izzudin01/Design-of-Two-Stage-BJT-Common-Emitter-Amplifier-2N2222-/Final Project Report_Desain Two Stage BJT 2N2222 Common Emitter Amplifier.pdf

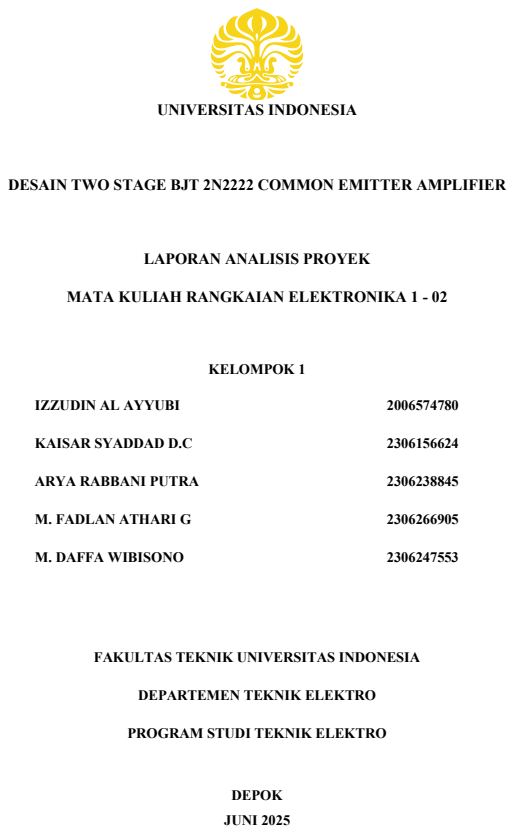
[picture p6: page 1]
UNIVERSITAS INDONESIA; KELOMPOK 1; IZZUDIN AL AYYUBI; KAISAR SYADDAD D.C; ARYA RABBANI PUTRA; M. FADLAN ATHARI G; M. DAFFA WIBISONO; DEPOK; JUNI 2025

DESAIN TWO STAGE BJT 2N2222 COMMON EMITTER AMPLIFIER

LAPORAN ANALISIS PROYEK

MATA KULIAH RANGKAIAN ELEKTRONIKA 1 - 02

FAKULTAS TEKNIK UNIVERSITAS INDONESIA

DEPARTEMEN TEKNIK ELEKTRO

PROGRAM STUDI TEKNIK ELEKTRO

i

DAFTAR ISI

### 4.1. Hasil Simulasi Rangkaian Two Stage BJT Common Emitter Amplifier . 18

4.1.1. Hasil Simulasi Interaktif Two Stage BJT Common Emitter Amplifier 18
4.1.2. Hasil Simulasi DC Operating Point Two Stage BJT Common Emitter
4.1.3. Hasil Simulasi AC Sweep Two Stage BJT Common Emitter Amplifier 22

### 4.2. Hasil Pengujian Rangkaian Two Stage BJT Common Emitter Amplifier

24

ii

DAFTAR GAMBAR

Gambar 3-1 Rangkaian Two Stage BJT Common Emitter Amplifier dengan Emitter

Gambar 3-3 Diagram Rangkaian Two Stage BJT 2N2222 Common Emitter Amplifier14

Gambar 4-1 Grafik Simulasi Rangkaian Two Stage BJT CE Amplifier dengan

iii

DAFTAR TABEL

Tabel 4-2 Perbandingan Nilai Perhitungan Teoritis dan Hasil Simulasi DC Operating

BAB 1

PENDAHULUAN

### 1.1. Latar Belakang

Penguat sinyal merupakan salah satu komponen penting dalam sistem elektronika,

terutama pada perangkat audio, komunikasi, dan instrumentasi. Salah satu konfigurasi

yang sering digunakan dalam penguatan sinyal analog adalah penguat common emitter

berbasis transistor BJT. Konfigurasi ini dipilih karena mampu memberikan penguatan

tegangan yang cukup besar serta memiliki karakteristik linieritas yang baik.

Dalam beberapa aplikasi, satu tahap penguatan tidak cukup untuk mencapai level

sinyal yang diinginkan. Oleh karena itu, dibutuhkan penguat dua tahap (two-stage

amplifier) untuk meningkatkan total gain sistem secara bertahap tanpa mengorbankan

kestabilan dan kualitas sinyal. Desain dua tahap juga memungkinkan kontrol yang lebih

baik terhadap titik kerja transistor dan respon frekuensi sistem.

Bipolar Juntion Transistor (BJT) banyak digunakan dalam aplikasi rangkaian

penguat karena memiliki karakteristik yang stabil, mudah diperoleh, dan cocok untuk

aplikasi frekuensi menengah. Dengan menggunakan pendekatan perancangan sistematis,

proyek ini bertujuan untuk merancang dan menguji performa penguat dua tahap dengan

konfigurasi common emitter menggunakan BJT, serta menganalisis hasilnya melalui

simulasi dan pengujian langsung.

### 1.2. Rumusan Masalah

Berdasarkan latar belakang, rumusan masalah dalam proyek ini dapat dirumuskan sebagai

berikut:

1. Bagaimana merancang sistem penguat dua tahap dengan konfigurasi common

emitter yang mampu bekerja secara optimal dalam rentang frekuensi audio?

2. Bagaimana menentukan nilai komponen yang sesuai agar diperoleh penguatan

tegangan (gain) yang stabil dan sesuai target?

3. Bagaimana mengevaluasi kinerja rangkaian melalui simulasi dan pengujian

langsung untuk memastikan sistem bekerja sesuai spesifikasi yang ditetapkan?

### 1.3. Tujuan

Tujuan dari proyek ini adalah untuk merancang, mensimulasikan, dan menguji rangkaian

penguat dua tahap dengan konfigurasi common emitter berbasis transistor BJT NPN agar

memenuhi spesifikasi penguatan dan kestabilan sinyal pada rentang frekuensi audio.

BAB 2

STUDI LITERATUR

### 2.1. Amplifier

Aplikasi rangkaian ini adalah sebagai amplifier, untuk mengamplify sinyal yang

masuk maka digunakan Bipolar Junction Transistor (BJT) yang berada dalam mode

common-emitter dengan konfigurasi input sinyal dimasukkan ke basis, output keluar

dari collector, dan emitter dihubungkan ke ground, dalam kondisi ini BJT akan berada

di active region dan akan mengamplify sinyal yang masuk.

2.1.1. Common-Emitter Amplifier

Konfigurasi common-emitter menempatkan emitter transistor sebagai terminal

bersama (ground AC), dengan sinyal masuk ke basis dan sinyal keluar dari kolektor.

Dalam konfigurasi ini penguatan sinyal input sangat besar, terjadinya pembalikan fasa

sebesar 180° antara input dan output, dengan BJT memiliki impedansi input yang

sedang dan impedansi output yang tinggi.

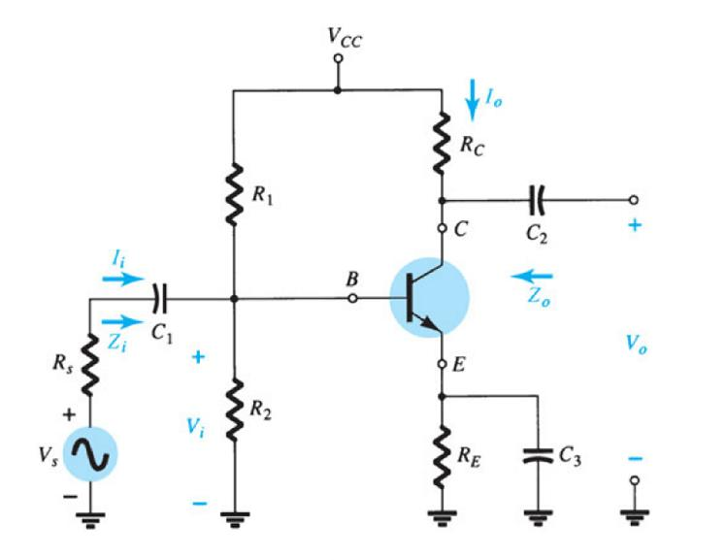
[picture p7: figure]

Gambar 2-1 Common Emitter Amplifier [1]

2.1.2. Multistage Amplifier

Rangkaian yang ingin kita buat adalah multistage ampilfier, yaitu rangkaian yang

menggabungkan dua atau lebih tahap penguat (misalnya CE, CC, atau CB) secara seri untuk mencapai gain total yang jauh lebih besar daripada satu tahap tunggal. Untuk

menjalankan multistage amplifier dibutuhkan kapasitor pemisah DC dan Direct

coupling, dua komponen tersebut harus diperhatikan untuk menjaga stabilitas dan

menghindari noice yang tajam.

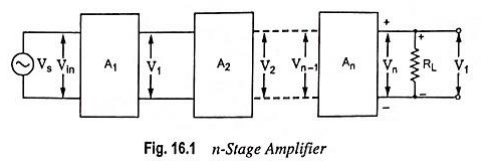
[picture p8: figure]

Gambar 2-2 Multistage Amplifier

BAB 3

PERANCANGAN SISTEM

### 3.1. Perancangan Two Stage BJT Common Emitter Amplifier

Metodologi perancangan Two Stage BJT Common Emitter Amplifier dilakukan

dengan pendekatan top-down, yaitu dimulai dari penentuan karakteristik sistem secara

umum, kemudian diturunkan ke dalam bentuk rancangan tiap stage secara bertahap.

Pendekatan ini dipilih karena memberikan kemudahan dalam mengontrol performa akhir

sistem serta memperjelas parameter-parameter kritis yang harus dicapai pada setiap

tingkat penguat.

3.1.1. Kriteria dan Target Desain

Desain two stage BJT amplifier ini masing-masing menggunakan konfigurasi

common emitter (CE) dengan voltage divider bias pada setiap stage-nya, sebagaimana

diperlihatkan pada Gambar berikut.

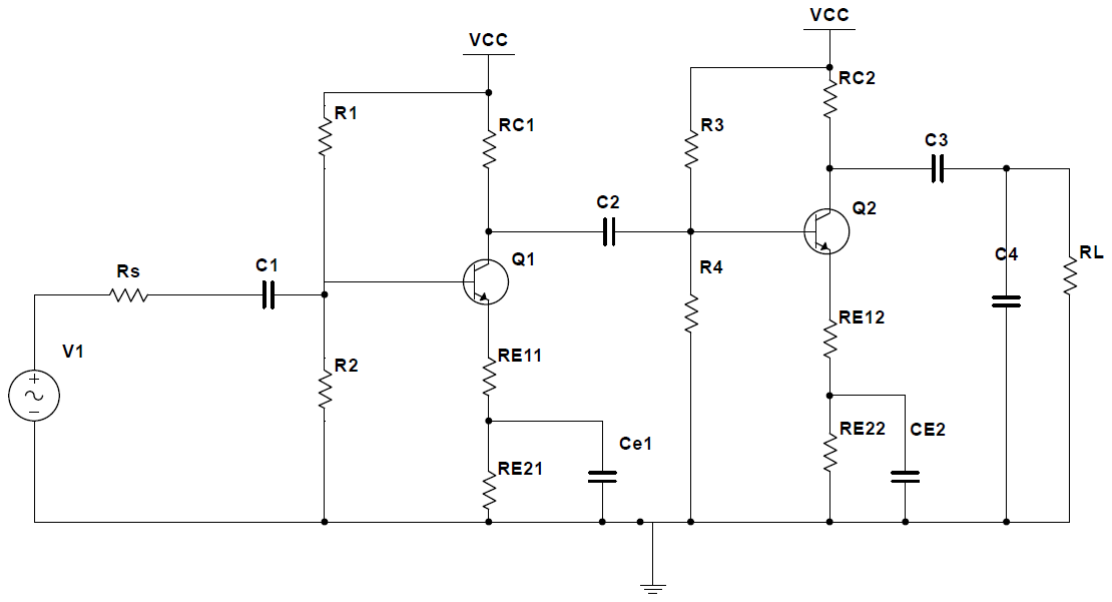
[picture p9: figure]

Gambar 3-1 Rangkaian Two Stage BJT Common Emitter Amplifier dengan Emitter Degeneration=--

Salah satu aspek penting dalam konfigurasi CE ini adalah penggunaan resistor

emitor (degeneration resistor) yang terdiri dari Re1 dan Re2. Penambahan resistor pada

jalur emitter bertujuan untuk memberikan stabilitas tambahan terhadap titik kerja

transistor. Resistor ini menciptakan efek feedback negatif yang meredam variasi arus

kolektor akibat perubahan suhu atau parameter transistor lainnya. Efek lain yang

menguntungkan dari resistor emitor adalah peningkatan linearitas sinyal dan penurunan

distorsi harmonik, yang sangat penting dalam aplikasi penguat sinyal analog. Untuk

mempertahankan penguatan AC tetap tinggi, sebuah kapasitor bypass (Ce) dipasang

paralel terhadap Re2. Kapasitor ini akan melewatkan sinyal AC melewati resistor Re2

sehingga efek feedback negatif hanya berlaku terhadap sinyal DC atau frekuensi rendah,

tanpa mengurangi penguatan sinyal pada frekuensi kerja utama.

Pemilihan transistor BJT NPN tipe 2N2222 dalam rangkaian ini didasarkan pada

karakteristiknya yang stabil, mudah diperoleh, dan sesuai untuk aplikasi frekuensi

menengah. Transistor 2N2222 memiliki penguatan arus (β) yang berada di kisaran 100

hingga 200, tegangan breakdown yang cukup tinggi, serta kecepatan switching dan gain

bandwidth product yang memadai untuk keperluan audio atau sinyal analog. Selain itu,

transistor ini memiliki kemampuan menangani arus kolektor hingga 800 mA,

memberikan margin operasional yang aman dan fleksibel. Kombinasi antara ketersediaan,

performa, dan harga yang terjangkau menjadikan 2N2222 sebagai pilihan yang tepat

dalam perancangan sistem amplifier dua tahap ini.

Sementara itu, target desain dari sistem penguat dua tingkat ini ditetapkan

berdasarkan kebutuhan penguatan sinyal kecil secara bertahap dan stabil, dengan tetap

menjaga kestabilan bias dan kualitas sinyal yang baik dalam rentang frekuensi audio.

Dalam sistem ini, ditetapkan sebagai berikut,

No. | Simbol | Parameter | Target
1 | Av | Overall Gain | 20
2 | |A1| | Gain First Stage | 5
3 | |A2| | Gain Second Stage | 4
4 | Rs | Resistansi Sumber Sinyal | 50 Ω
5 | RL | Resistansi Beban | 1 kΩ

6 | BW | Bandwidth | 20 Hz – 20 kHz
7 | β | Beta | 100 – 200
8 | Vcc | Tegangan suplai | 5 V

Tabel 3-1 Target Spesifikasi Desain

3.1.2. Perhitungan Teoritis

Perhitungan teoritis dilakukan untuk menentukan nilai-nilai komponen utama

dalam rangkaian two stage BJT common emitter amplifier. Perancangan dilakukan secara

sistematis dari tahap kedua ke tahap pertama (bottom-up) untuk memastikan beban yang

diterima oleh masing-masing stage sesuai dan penguatan total dapat dicapai sesuai target.

Gambar 3-2 Two Port System

3.1.2.1. Desain Second Stage Amplifier

Second stage merupakan tahap akhir yang langsung menguatkan sinyal untuk

diberikan ke beban (RL). Untuk mencapai transfer daya maksimum dari second stage

amplifier menuju beban maka dibutuhkan,

Zo2 = RL = 1kΩ

Dengan demikian, gain second stage menjadi,

Av2 =

RL
Zo2 + RL

AvNL2

Av2 =

1
2

AvNL2

Berdasarkan Tabel 3-1, |Av2

| telah ditentukan, sehingga

|AvNL2

|= 2|Av2| = 8

Untuk memperoleh amplifikasi dengan maksimum output tegangan swing tidak

terdistorsi, Q-point harus berada dekat dengan posisi tengah load line,

Vc =

1
2

Vcc = 2.5 V

VE = 0.1Vcc = 0.5 V

Karena Zo2 = 1kΩ, maka

RC = Zo = 1kΩ

Dengan demikian, arus collector dapat diperoleh sebagai berikut,

IC =

VCC − VC
RC

=

5 − 2.5
1 × 10³ = 0.0025 A = 2.5 mA

Diasumsikan IC ≅ IE, dengan demikian,

IE = 2.5 mA

RE = RE1 + RE2 =

VE
IE

= 200 Ω

re =

26mV
IE

= 10.4 Ω

Berdasarkan nilai re yang telah diperoleh,

|AVNL2

| = 8 =

RC
RE1 + re

8 =

1000
RE1 + 10.4
RE1 = 114.6 Ω

RE2 = RE − RE1 = 86.4 Ω

Kemudian, untuk menentukan resistansi voltage divider yaitu R1 dan R2 ,

dibutuhkan nilai arus yang mengalir melewati rangkaian potential divider yang besar

dibandingkan arus base sebenarnya (IB), sehingga diasumsikan nilainya 10 kali dari IB

mengalir melalui resistor R2. Perkiraan arus base adalah sebagai berikut,

IB =

IC
β

=

2.5mA
100 = 25 nA

R2 ≤

VE + VBE
10 × IB

= 4.8kΩ

Sehingga, nilai R2 yang dipilih berdasarkan constraint di atas adalah 4000 ohm.

Sementara itu, berdasarkan constraint voltage divider,

R2
R1 + R2

VCC = VE + VBE

4000
R1 + 4000

× 5 = 0.5 + 0.7

R1 = 12.67kΩ

Dengan demikian, impedansi input adalah,

Zi = R1||R2

||β(RE1 + re
)

Zi = 12.67kΩ||4kΩ||100(114.6 + 10.4)

Zi2 = 2445.3 Ω

Emitter bypass capacitor untuk lower frequency response 20 Hz pada -3 dB,

CE =

1
2πReqfL

Sementara nilai Req yaitu

Req = RE2||re

|| (RE1 +

zo1||R1||R2
β

) = 52.83 Ω

Sehingga nilai CE = 150.62 μF

Dengan demikian, diperoleh nilai parameter untuk masing-masing komponen pada

second stage pada Tabel berikut,

No. | Komponen | Nilai Teoritis | Nilai Standar Komersil
1 | RC | 1 kΩ | 1 kΩ

2 | RE1 | 114.60 Ω | 100 Ω
3 | RE2 | 85.40 Ω | 100 Ω
4 | R2 | 4.8 kΩ | 3.3 k & 1kΩ
5 | R1 | 12.67 kΩ | 10 k & 1 kΩ
6 | CE1 | 150.62 μF | 100 μF

Tabel 3-2 Nilai Parameter Teoritis dan Standar Komersil

3.1.2.2. Desain First Stage Amplifier

First stage amplifier adalah blok penguat pertama yang langsung menerima sinyal

dari sumber sinyal. Untuk mencapai transfer daya maksimum dari first stage amplifier

menuju second stage amplifier maka dibutuhkan,

Zo1 = Zi2 = 2445.3 Ω

Dengan demikian, gain first stage menjadi,

Av1 = (

Zi1
Zi1 + Rs

) (

Zi2

Zi2 + Zo1

) AvNL1

Berdasarkan Tabel 3-1, |Av1

| telah ditentukan, sehingga

|AvNL1

| = 10.11

Untuk memperoleh amplifikasi dengan maksimum output tegangan swing tidak

terdistorsi, Q-point harus berada dekat dengan posisi tengah load line,

Vc =

1
2

Vcc = 2.5 V

VE = 0.1Vcc = 0.5 V

Karena Zo1 = 2445.3 Ω, maka

RC = Zo1 = 2445.3 Ω

Dengan demikian, arus collector dapat diperoleh sebagai berikut,

IC =

VCC − VC
RC

=

5 − 2.5
2445.3

= 1.041 mA

Diasumsikan IC ≅ IE, dengan demikian,

IE = 1.041 mA

RE = RE1 + RE2 =

VE
IE

= 480 Ω

re =

26mV
IE

= 24.96 Ω

Berdasarkan nilai re yang telah diperoleh,

|AVNL1

| = 10.11 =

RC
RE1 + re

RE1 = 212.34 Ω

RE2 = RE − RE1 = 267.66 Ω

Kemudian, untuk menentukan resistansi voltage divider yaitu R1 dan R2 ,

dibutuhkan nilai arus yang mengalir melewati rangkaian potential divider yang besar

dibandingkan arus base sebenarnya (IB), sehingga diasumsikan nilainya 10 kali dari IB

mengalir melalui resistor R2. Perkiraan arus base adalah sebagai berikut,

IB =

IC
β

=

1.041 mA
100 = 10.4 nA

R2 ≤

VE + VBE
10 × IB

= 11.520 kΩ

Sehingga, nilai R2 yang dipilih berdasarkan constraint di atas adalah 11000 ohm.

Sementara itu, berdasarkan constraint voltage divider,

R2
R1 + R2

VCC = VE + VBE

11000
R1 + 11000

× 5 = 0.5 + 0.7

R1 = 34.83 kΩ

Dengan demikian, impedansi input adalah,

Zi = R1||R2

||β(RE1 + re
)

Zi1 = 6182.07 Ω

Emitter bypass capacitor untuk lower frequency response 20 Hz pada -3 dB,

CE =

1
2πReqfL

Sementara nilai Req yaitu

Req = RE2||re

|| (RE1 +

zo1||R1||R2
β

) = 135.11 Ω

Sehingga nilai CE = 58.9 μF

Dengan demikian, diperoleh nilai parameter untuk masing-masing komponen pada

second stage pada Tabel berikut,

No. | Komponen | Nilai Teoritis | Nilai Standar Komersil
1 | RC | 2.4 kΩ | 1 kΩ x 2 (seri)
2 | RE1 | 212.34 Ω | 100 Ω x 2 (seri)
3 | RE2 | 267.66 Ω | 100 Ω x 2 (seri)
4 | R2 | 11.52 kΩ | 10 k
5 | R1 | 34.83 kΩ | 20 kΩ
6 | CE1 | 58.90 μF | 47 μF

Tabel 3-3 Nilai Parameter Teoritis dan Standar Komersil

3.1.2.3. Coupling Capacitor

Coupling capacitor pada rangkaian two stage BJT CE amplifier berfungsi untuk

mengalirkan sinyal AC antar stage amplifier sambil menahan aliran komponen DC.

Perhitungan coupling capacitor yang meliputi coupling capacitor di antara sumber sinyal

dan first stage amplifier, coupling capacitor di antara first stage dan second stage

amplifier, serta coupling capacitor di antara second stage amplifier dan beban adalah

sebagai berikut,

1. Coupling Capacitor di antara sumber sinyal dan first stage amplifier

Req = Rs + Zi1

Req = 6.23 kΩ

Untuk frequency response pada 20Hz (-3dB),

CC =

1
2πReqfL

= 1.27μF

2. Coupling Capacitor di antara first stage dan second stage amplifier

Req = Zo1 + Zi2

Req = 4.84 kΩ

Untuk frequency response pada 20Hz (-3dB),

CC =

1
2πReqfL

= 1.64μF

3. Coupling Capacitor di antara second stage dan beban

Req = RL + Zo2

Req = 2 kΩ

Untuk frequency response pada 20Hz (-3dB),

CC =

1
2πReqfL

= 3.97μF

4. High Frequency Cutoff Capacitor

Amplifier memiliki cutoff frequency dalam rentang MHz, sehingga dibutuhkan

cutoff di sekitar 20 kHz, sehingga diaplikasikan RC lowpass filter pada output

sebagai berikut,

Req = RL

||Zo2

Req = 500 Ω

Untuk frequency response pada 20 kHz (-3dB),

CC =

1
2πReqfH

= 15.91 nF

Hasil akhir perancangan rangkaian adalah seperti yang ditunjukkan oleh Gambar 3-

3 sebagai berikut,

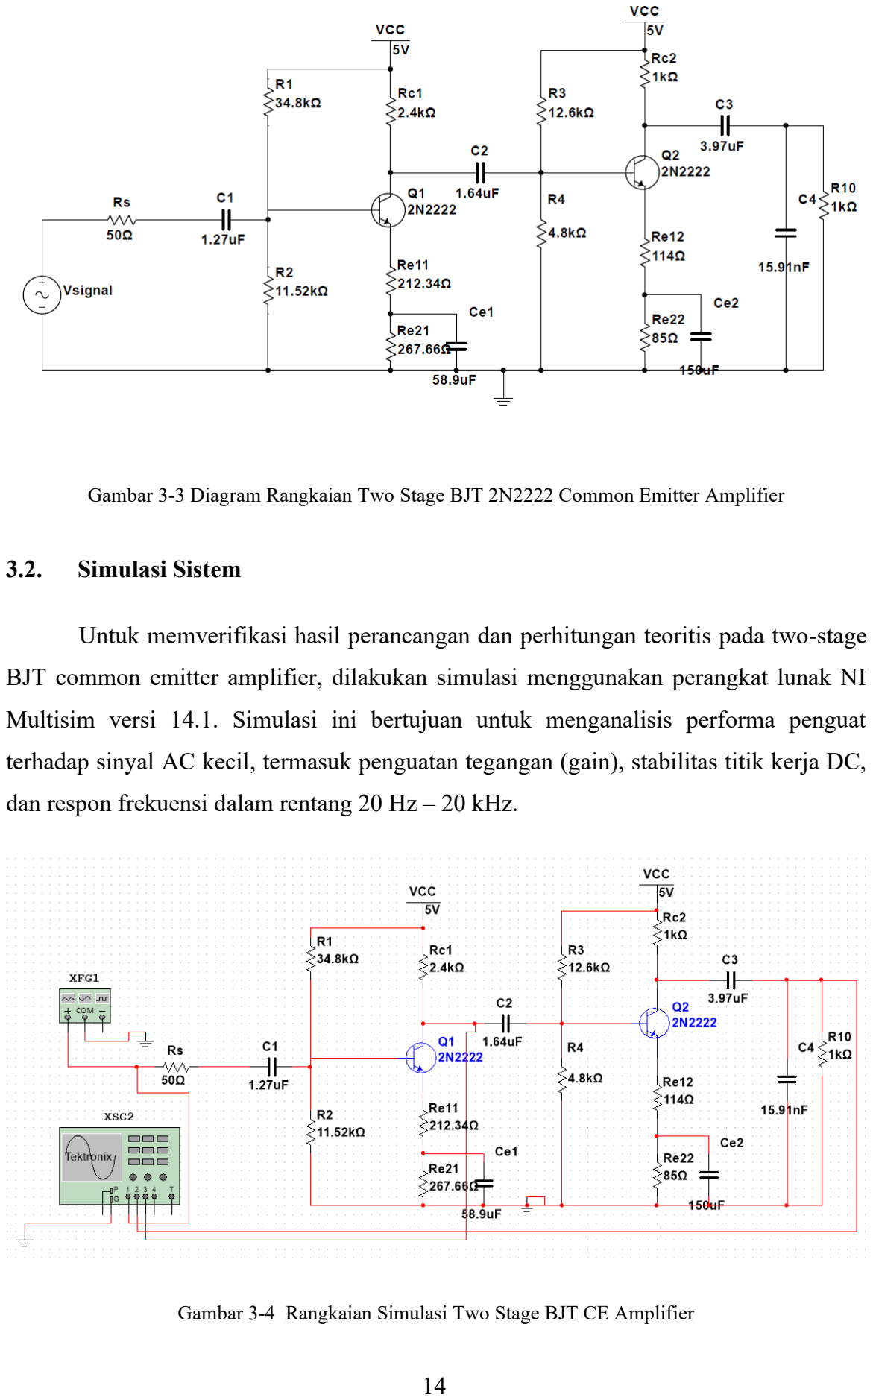
[picture p10: page 18]

Gambar 3-3 Diagram Rangkaian Two Stage BJT 2N2222 Common Emitter Amplifier

### 3.2. Simulasi Sistem

Untuk memverifikasi hasil perancangan dan perhitungan teoritis pada two-stage

BJT common emitter amplifier, dilakukan simulasi menggunakan perangkat lunak NI

Multisim versi 14.1. Simulasi ini bertujuan untuk menganalisis performa penguat

terhadap sinyal AC kecil, termasuk penguatan tegangan (gain), stabilitas titik kerja DC,

dan respon frekuensi dalam rentang 20 Hz – 20 kHz.

Gambar 3-4 Rangkaian Simulasi Two Stage BJT CE Amplifier

Sebagaimana Gambar 3-4, beberapa komponen seperti Function Generator dan

Oscilloscope ditambahkan. Komponen Function Generator XFG1 berfungsi sebagai

sumber sinyal AC untuk menggerakkan rangkaian amplifier. Konfigurasi sinyal yang

diterapkan pada XFG1 dalam simulasi adalah sebagai berikut,

1. Bentuk Gelombang : Sinusoidal (Sine wave)
2. Frekuensi | : 1 kHz
3. Amplitudo | : 25 mVp
4. DC offset | : 0 V
5. Impedansi Rs | : 50 Ω

Sementara itu, dalam simulasi ini, oscilloscope XSC1 digunakan sebagai alat

utama untuk memantau dan menganalisis bentuk gelombang sinyal di berbagai titik

penting dalam rangkaian amplifier. Osiloskop memberikan representasi visual dari sinyal

tegangan terhadap waktu, sehingga sangat membantu dalam mengevaluasi performa

penguatan, kestabilan bentuk gelombang, dan keberadaan distorsi atau clipping. Untuk

memperoleh informasi yang kompherensif, digunakan tiga channel pada oscilloscope.

channel 1 (CH1) dihubungkan langsung ke input sinyal dari sumber. Channel ini

berfungsi sebagai acuan untuk mengamati seberapa besar amplitudo sinyal masukan yang

diberikan ke sistem. Kemudian, channel 2 (CH2) dihubungkan ke titik output akhir dari

keseluruhan amplifier di dekat beban setelah second stage amplifier. Channel ini

merepresentasikan sinyal keluaran akhir (Vo2) dari seluruh rangkaian two-stage amplifier,

dan menjadi acuan utama dalam mengukur gain total sistem (Av ). Sedangkan untuk

Channel 3 (CH3), ia menunjukkan hasil first stage amplifier (Vo₁), dan memungkinkan

pengguna mengevaluasi apakah penguatan sebesar A₁ telah tercapai.

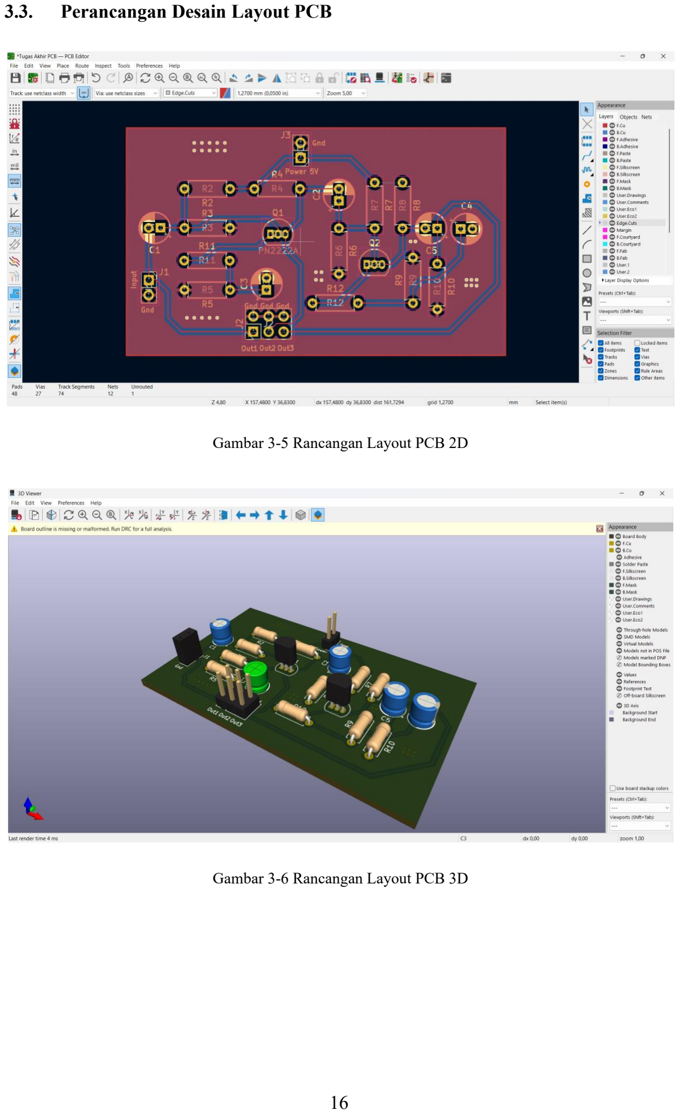
[picture p11: page 20]

### 3.3. Perancangan Desain Layout PCB

Gambar 3-5 Rancangan Layout PCB 2D

Gambar 3-6 Rancangan Layout PCB 3D

### 3.4. Pengujian Sistem

Pengujian sistem ini dilakukan dengan merangkai mengikuti skematik yang telah

dibuat sebelumnya, hanya saja terdapat perbedaan kecil dari besaran komponen resistor

dan kapasitor yang digunakan. Hal ini dikarenakan besaran resistor dan kapasitor yang

ada di pasaran hanya terbatas sehingga perlu untuk mencari besaran yang mendekati

skematik dan nilai teori di awal. Sistem dirangkai menggunakan breadboard untuk

prototipe karena dengan menggunakan breadboard lebih memudahkan dalam merangkai

dan troubleshooting jika terjadi suatu masalah atau kesalahan. Setelah sistem berhasil

dirangkai, sistem dicoba menggunakan NI ELVIS board karena sudah terdapat suplai

daya 5V dan Function Generator yang dapat diatur menggunakan software NI ELVIS di

laptop. NI ELVIS juga sudah memiliki osciloscope sehingga grafik dapat dilihat langsung

dari laptop. Sistem diuji dengan mengubah variabel frekuensi sesuai dengan pengujian

yang telah dilakukan berdasarkan teori dan simulasi. Karena range frekuensi yang dapat

diberikan oleh NI ELVIS hanya terbatas sehingga frekuensi pengujian ada pada 20Hz,

100Hz, dan 1kHz.

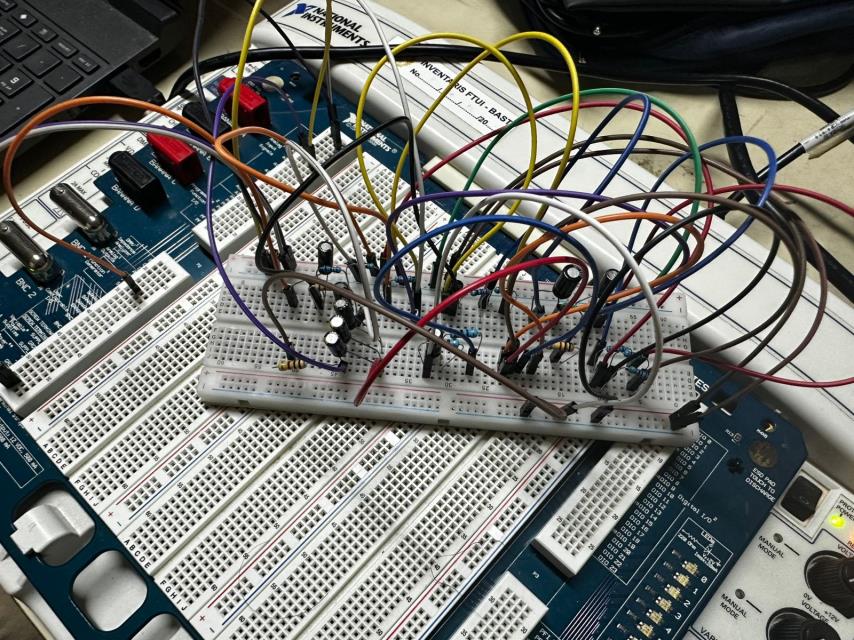
[picture p12: figure]

Gambar 3-7 Pengujian Sistem dengan NI ELVIS

BAB 4

HASIL DAN PEMBAHASAN

### 4.1. Hasil Simulasi Rangkaian Two Stage BJT Common Emitter Amplifier

4.1.1. Hasil Simulasi Interaktif Two Stage BJT Common Emitter Amplifier

Simulasi ini bertujuan untuk mengevaluasi performa rangkaian Two-Stage BJT

Common Emitter Amplifier dalam kondisi frekuensi yang berbeda-beda. Pengujian

dilakukan menggunakan tiga kanal pada osiloskop untuk mengamati sinyal input (CH1),

sinyal output beban (CH2), dan output dari amplifier tahap pertama (CH3). Pada gambar

4-1, terlihat hasil simulasi dengan frekuensi yang berbeda pada setiap tahap pengujian.

Gambar ini menunjukkan respons terhadap perubahan frekuensi dan bagaimana

amplitudo sinyal keluarannya (baik dari tahap pertama maupun tahap kedua) terpengaruh

oleh frekuensi input.

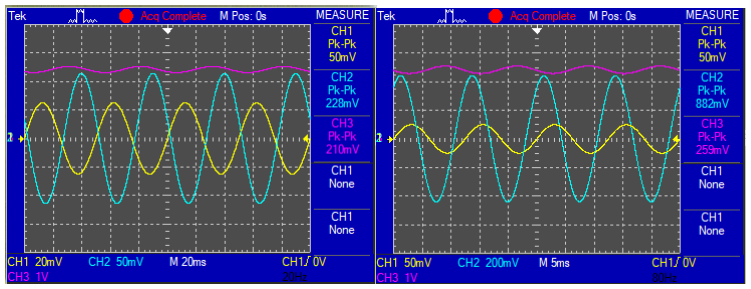
[picture p13: figure]
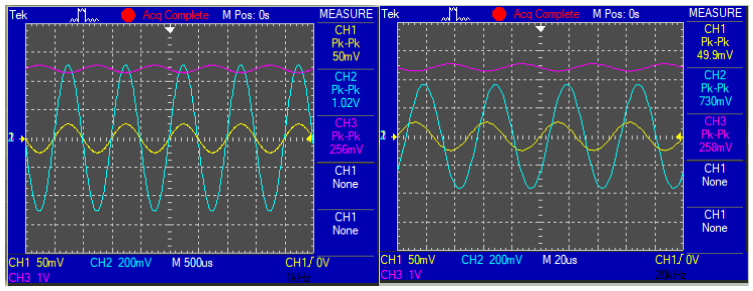
[picture p14: figure]

Gambar 4-1 Grafik Simulasi Rangkaian Two Stage BJT CE Amplifier dengan Oscilloscope

No. | Frekuensi | CH1 | CH2 | CH3 | Av1 | Av2 | Av
| | Vsignal (mVpp) | Vout2 (mVpp) | Vout1 (mVpp)
1 | 20 Hz | 50 | 228 | 210 | 4.2 | 1.09 | 4.56
2 | 40 Hz | 50 | 608 | 255 | 5.1 | 2.38 | 12.16
3 | 80 Hz | 50 | 882 | 259 | 5.18 | 3.41 | 17.64
4 | 100 Hz | 50 | 928 | 259 | 5.18 | 3.58 | 18.56
5 | 200 Hz | 50 | 995 | 257 | 5.14 | 3.87 | 19.9
6 | 400 Hz | 50 | 1010 | 257 | 5.14 | 3.93 | 20.2
7 | 800 Hz | 50 | 1020 | 256 | 5.12 | 3.98 | 20.4
8 | 1 kHz | 50 | 1020 | 256 | 5.12 | 3.98 | 20.4
9 | 2 kHz | 50 | 1010 | 256 | 5.12 | 3.95 | 20.2
10 | 4 kHz | 50 | 1000 | 256 | 5.12 | 3.91 | 20
11 | 8 kHz | 50 | 950 | 257 | 5.14 | 3.70 | 19
12 | 10 kHz | 50 | 916 | 257 | 5.14 | 3.56 | 18.32
13 | 20 kHz | 50 | 730 | 258 | 5.16 | 2.83 | 14.6
14 | 40 kHz | 50 | 464 | 259 | 5.18 | 1.79 | 9.28
15 | 80 kHz | 50 | 253 | 260 | 5.2 | 0.97 | 5.06
16 | 100 kHz | 50 | 205 | 260 | 5.2 | 0.79 | 4.1
17 | 200 kHz | 50 | 104 | 259 | 5.18 | 0.40 | 2.08

Tabel 4-1 Hasil Simulasi Rangkaian Two Stage BJT CE Amplifier

Berdasarkan tabel 4-1, pada rentang frekuensi rendah 20 Hz hingga 100 Hz,

overall gain (Av) masih belum mencapai performa yang optimal. Salah satu hal yang

perlu diperhatikan adalah low frequency cutoff yang terjadi sekitar 50 Hz. Hal ini tidak

sesuai dengan target desain yang sebelumnya ditetapkan pada sekitar 20 Hz. Sebagai

amplifier yang dirancang untuk bekerja pada frekuensi rendah hingga menengah, batasan

pada frekuensi sekitar 50 Hz menunjukkan bahwa rangkaian ini mengalami penurunan

performa pada frekuensi yang lebih rendah daripada yang diinginkan. Di samping itu,

dapat juga dilihat Meskipun amplifier mampu mengamplifikasi sinyal, gain yang

dihasilkan masih lebih rendah dari target yang diinginkan. Ini bisa disebabkan oleh faktor-faktor seperti pengaruh kapasitansi parasitik atau pengaturan komponen yang tidak

sepenuhnya sesuai dengan desain yang diharapkan pada frekuensi rendah.

Sementara pada rentang frekuensi midband 100 Hz hingga 8 kHz, performa

amplifier menunjukkan hasil yang lebih baik. Overall gain (Av) pada rentang ini sudah

stabil, dengan penguatan yang telah optimal. Hal ini menunjukkan bahwa, pengaruh

kapasitansi parasitik dan induktansi rangkaian menjadi sangat kecil, yang berarti bahwa

komponen aktif seperti transistor dapat beroperasi pada titik kerja yang lebih optimal.

Penguatan pada first stage amplifier (Av1) juga tetap optimal, mencerminkan desain yang

cukup baik untuk menangani sinyal audio pada rentang frekuensi ini.

Pada rentang frekuensi ini, terjadi sedikit penurunan pada Av dan Av1, yang dapat

dilihat dari pengurangan sedikit demi sedikit pada nilai output (CH2) dibandingkan

dengan sinyal input (CH1). Pada frekuensi 20 kHz, nilai Av tercatat 14.6, yang

menunjukkan -3 dB dari nilai maksimal dan sesuai dengan high frequency cutoff yang

diharapkan pada rentang 20 kHz. Penurunan gain sebesar -3 dB adalah fenomena umum

pada batas cutoff frekuensi tinggi, yang mengindikasikan bahwa amplifier mulai

mengalami penguatan yang berkurang saat frekuensi mendekati batas desainnya. Hal ini

merupakan perilaku normal karena amplifier tidak dirancang untuk menangani frekuensi

lebih tinggi.

Di samping itu, dalam hasil simulasi yang diperoleh, Av2 menunjukkan bahwa

nilai penguatan pada tahap kedua cenderung tidak mencapai nilai optimalnya, yaitu

sekitar 4, pada dua rentang frekuensi tertentu, yakni 20 Hz hingga 100 Hz dan 10 kHz

hingga 200 kHz. Fenomena ini menunjukkan bahwa tahap kedua amplifier lebih sensitif

terhadap pengaruh faktor-faktor seperti kapasitansi parasitik, impedansi beban, dan GBW

dibandingkan dengan tahap pertama.

4.1.2. Hasil Simulasi DC Operating Point Two Stage BJT Common Emitter Amplifier

Pada subbab ini, dilakukan analisis terhadap DC operating point hasil simulasi

pada rangkaian Two-Stage BJT Common Emitter Amplifier. DC operating point merujuk

pada kondisi biasing statis di mana transistor beroperasi sebelum adanya sinyal input AC.

Kondisi ini sangat penting karena menentukan apakah transistor beroperasi pada titik yang sesuai untuk memastikan penguatan sinyal yang optimal dan menghindari terjadinya

distorsi atau pengaruh lainnya.

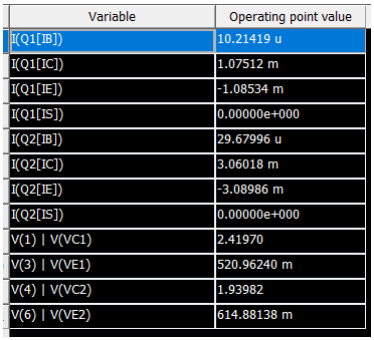
[picture p15: figure]

Gambar 4-2 Hasil Simulasi DC Operating Point

No. | Parameter | Nilai Perhitungan Teoritis | Nilai Hasil Simulasi
1 | IB1 | 10.4 μA | 10.21 μA
2 | IC1 | 1.041 mA | 1.075 mA
3 | IE1 | 1.041 mA | 1.085 mA
4 | IB2 | 25 μA | 29.67 μA
5 | IC2 | 2.5 mA | 3.06 mA
6 | IE2 | 2.5 mA | 3.089 mA
7 | VC1 | 2.5 V | 2.419 V
8 | VE1 | 0.5 V | 0.52 V
9 | VC2 | 2.5 V | 1.94 V
10 | VE2 | 0.5 V | 0.61 V

Tabel 4-2 Perbandingan Nilai Perhitungan Teoritis dan Hasil Simulasi DC Operating Point

Berdasarkan Tabel 4-2, perbandingan antara nilai perhitungan teoritis dan nilai

hasil simulasi untuk berbagai parameter dalam rangkaian dua tahap amplifier menunjukkan beberapa perbedaan kecil. Untuk arus basis (IB1 dan IB2), hasil simulasi

menunjukkan bahwa IB1 (10.21 µA vs 10.4 µA) memiliki perbedaan yang sangat kecil

dengan perhitungan teoritis, yang menunjukkan bahwa transistor Q1 bekerja sesuai

dengan yang diharapkan. Namun, pada IB2, arus basis Q2 lebih tinggi dalam simulasi

(29.67 µA vs 25 µA), yang mengindikasikan bahwa transistor Q2 memiliki pengaturan

bias lebih tinggi dalam simulasi, menyebabkan arus basisnya lebih besar.

Sementara untuk arus kolektor (IC1 dan IC2), perbedaan yang lebih kecil terlihat

pada IC1 (1.075 mA vs 1.041 mA), yang masih dalam batas yang dapat diterima. Namun,

pada IC2, terdapat peningkatan yang signifikan pada hasil simulasi (3.06 mA vs 2.5 mA),

yang menunjukkan bahwa Q2 mengalirkan lebih banyak arus kolektor dalam simulasi,

mungkin karena pengaruh bias yang lebih kuat atau perubahan kondisi lainnya dalam

rangkaian. Untuk arus emitor (IE1 dan IE2), IE1 sedikit lebih tinggi dalam hasil simulasi

(1.085 mA vs 1.041 mA), yang mencerminkan perbedaan kecil dalam kinerja Q1 antara

teori dan simulasi. Pada IE2, hasil simulasi menunjukkan bahwa Q2 mengalirkan lebih

banyak arus emitor (3.089 mA vs 2.5 mA), yang bisa disebabkan oleh pengaruh bias atau

ketidaksesuaian model transistor yang digunakan dalam simulasi.

Tegangan kolektor (VC1 dan VC2) menunjukkan bahwa pada Q1, tegangan

kolektor sedikit lebih rendah dalam simulasi (2.419 V vs 2.5 V), mungkin disebabkan

oleh pengaruh resistansi atau faktor non-ideal lainnya. Sedangkan pada Q2, tegangan

kolektor lebih rendah dalam simulasi (1.94 V vs 2.5 V), yang mengindikasikan perbedaan

dalam pengaturan bias atau peningkatan arus kolektor yang lebih besar. Untuk tegangan

emitor (VE1 dan VE2), VE1 sedikit lebih tinggi dalam hasil simulasi (0.52 V vs 0.5 V),

menunjukkan sedikit perbedaan dalam biasing Q1. Namun, pada VE2, tegangan emitor

pada Q2 lebih tinggi dalam simulasi (0.61 V vs 0.5 V), yang mungkin disebabkan oleh

perbedaan dalam pengaturan bias atau model yang digunakan dalam simulasi.

4.1.3. Hasil Simulasi AC Sweep Two Stage BJT Common Emitter Amplifier

Simulasi AC Sweep juga dilakukan untuk menganalisis kinerja suatu sistem

amplifier terhadap variasi frekuensi. Pada Gambar 4-2 bagian magnitude plot, dapat

diperoleh informasi bagaimana penguatan sistem berubah seiring dengan perubahan

frekuensi.

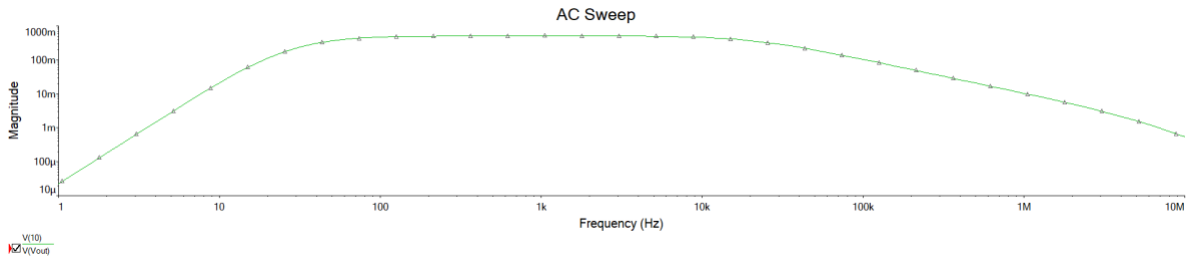
[picture p16: figure]
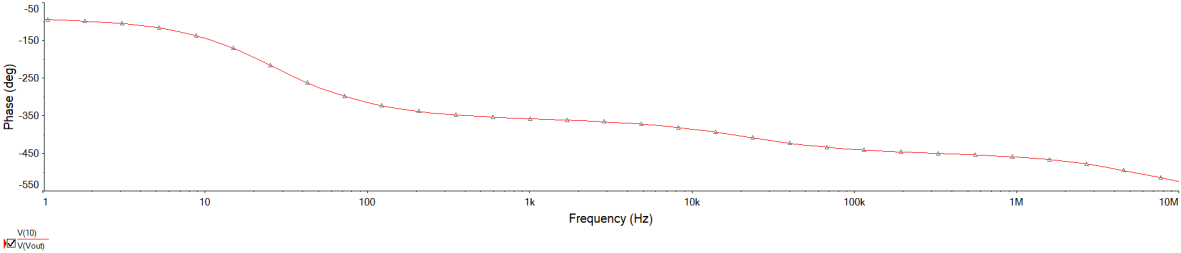
[picture p17: figure]

Gambar 4-3 Bode Plot Simulasi Rangkaian Two Stage BJT CE Amplifier

Pada rentang frekuensi rendah, dapat dilihat bahwa gain mengalami peningkatan

secara linier terhadap frekuensi. Sedangkan pada rentang midband (1-10 kHz),

karakteristik gain terhadap frekuensi yang dapat diperoleh menunjukkan bahwa sistem

amplifier berfungsi dengan baik dalam rentang frekuensi ini dan tidak mengalami

penurunan penguatan yang signifikan. Hal ini menunjukkan two stage BJT CE amplifier

dapat beroperasi secara optimal pada rentang frekuensi ini. Sedangkan pada rentang

frekuensi tinggi, terjadi penurunan di mana komponen-komponen seperti kapasitansi

parasitik mulai menghambat penguatan lebih lanjut.

Sedangkan pada phase plot, terjadi pergeseran fasa seiring peningkatan frekuensi.

Pada rentang frekuensi rendah, pergeseran fase dimulai pada sekitar -50°. Pada frekuensi

rendah, fase antara input dan output masih relatif kecil, menunjukkan bahwa sinyal output

mengikuti sinyal input dengan sedikit pergeseran. Sementara pada rentang frekuensi

midband, pergeseran fase yang terjadi lebih dari -270°. Sedangkan pada frekuensi 1 kHz,

pergeseran fase tercatat sekitar -360°. Hal ini menunjukkan bahwa sinyal input dan output

menjadi satu fase pada titik ini. Secara praktis, ini berarti bahwa output mengikuti input

dengan presisi, tanpa adanya penundaan waktu yang signifikan antara keduanya. Pada

frekuensi ini, sinyal output sepenuhnya sejajar dengan sinyal input, yang

mengindikasikan bahwa amplifier tidak mengalami pergeseran fase. Untuk frekuensi

tinggi, pergeseran fase menjadi semakin besar sehingga tidak lagi sefase dengan sinyal

input.

### 4.2. Hasil Pengujian Rangkaian Two Stage BJT Common Emitter Amplifier

Sesuai metode pengujian yang dilakukan, maka didapatkan tiga hasil berbeda

untuk variasi frekuensi yang dilakukan yaitu 20Hz, 100Hz, dan 1kHz sesuai dengan

gambar berikut,

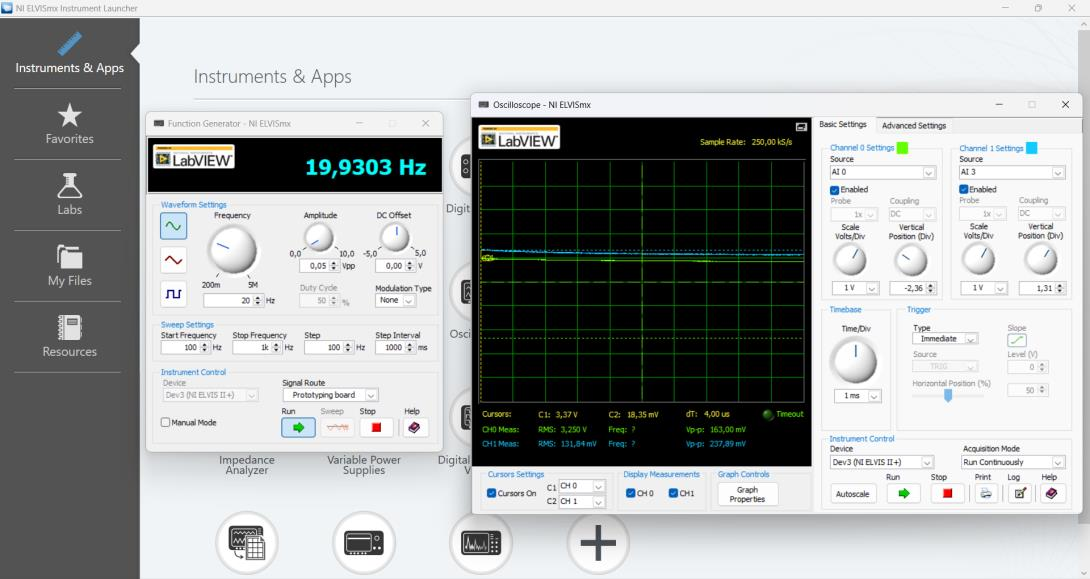
[picture p18: figure]

Gambar 4-4 Grafik Hasil Pengujian 20Hz

Pada frekuensi 19.9 Hz, kita melihat penguatan yang cukup stabil pada output

amplifier pertama (Vout1) dan output keseluruhan (Vout2). Vpp untuk output amplifier

pertama (Vout1) adalah 163 mV, dan Vpp untuk output keseluruhan (Vout2) adalah

237.89 mV, yang sesuai dengan prediksi penguatan pada frekuensi rendah. Gain yang

diperoleh pada tahap pertama (Av1) adalah 4.2, sementara gain total (Av) adalah 4.56.

Namun, jika dibandingkan dengan nilai Av1 dan Av pada tabel sebelumnya, nilai Av1

(4.2) sedikit lebih rendah dari yang tertera pada tabel simulasi (4.56).

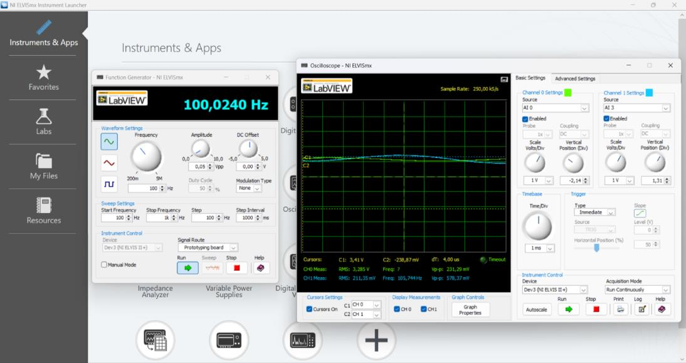
[picture p19: figure]

Gambar 4-5 Grafik Hasil Pengujian 100Hz

Sementara, pada 100 Hz, penguatan menunjukkan hasil yang lebih baik pada

output amplifier pertama (Vout1) dan output keseluruhan (Vout2). Vpp untuk output

amplifier pertama (Vout1) tercatat 231.29 mV, sedangkan output keseluruhan (Vout2)

tercatat 578.37 mV, menunjukkan bahwa penguatan pada frekuensi ini lebih optimal.

Nilai Av1 untuk tahap pertama adalah 5.18, dan Av2 untuk output keseluruhan adalah

3.93, menghasilkan Av total sebesar 20.2. Dibandingkan dengan tabel simulasi,

penguatan pada frekuensi 100 Hz lebih tinggi dari prediksi sebelumnya, yang

menunjukkan bahwa amplifier bekerja dengan sangat baik pada rentang midband ini.

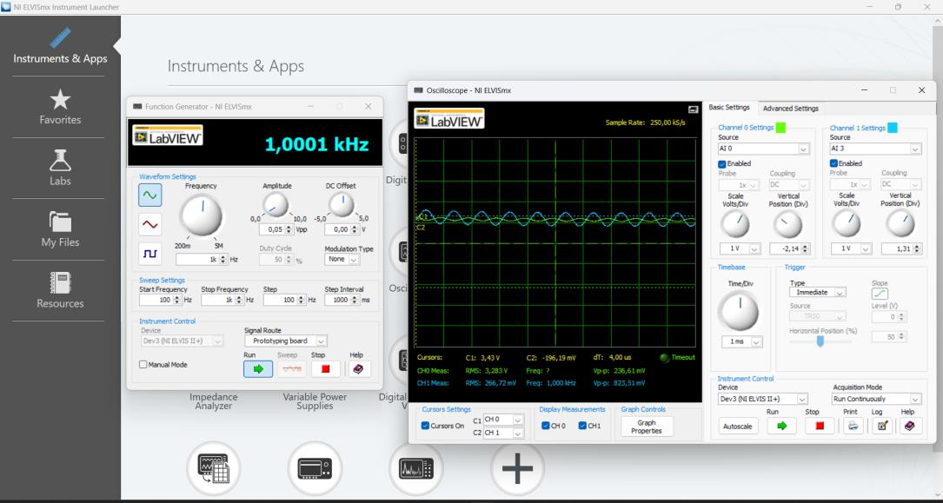
[picture p20: figure]

Gambar 4-6 Grafik Hasil Pengujian 1kHz

Sedangkan, pada frekuensi 1000 Hz, penguatan tetap terjaga baik pada output

amplifier pertama (Vout1) dan output keseluruhan (Vout2). Vpp untuk output amplifier

pertama (Vout1) adalah 236.61 mV, sementara output keseluruhan (Vout2) tercatat

823.51 mV. Penguatan pada frekuensi ini menunjukkan hasil yang stabil dan lebih tinggi,

yang mencerminkan performansi optimal amplifier pada frekuensi midband. Nilai Av1

pada tahap pertama tercatat 5.12, dan Av2 pada output keseluruhan adalah 3.98, yang

menghasilkan Av total 20.4, sedikit lebih tinggi dari hasil yang diperoleh pada simulasi

sebelumnya pada frekuensi ini. Hal ini menunjukkan bahwa amplifier bekerja dengan

baik pada frekuensi 1 kHz, memberikan penguatan yang stabil tanpa penurunan yang

signifikan.

Kemudian, salah satu alasan utama perbedaan antara nilai hasil pengujian dan

yang tertera dalam tabel simulasi adalah penggunaan nilai komponen komersial yang

tersedia di pasar. Komponen yang digunakan dalam rangkaian praktis sering kali tidak

dapat memenuhi secara sempurna nilai-nilai yang diharapkan berdasarkan perhitungan

teoritis. Hal ini disebabkan oleh toleransi pabrik pada komponen-komponen seperti

resistor, kapasitor, dan transistor, yang dapat menyebabkan deviasi dalam nilai-nilai

komponen tersebut. Misalnya, resistor memiliki toleransi yang memungkinkan variasi

nilai sebesar ±1%, ±5%, atau bahkan lebih besar pada komponen tertentu. Kapasitor juga

memiliki toleransi kapasitas yang dapat mempengaruhi penguatan atau frekuensi cutoff yang dihitung. Selain itu, transistor memiliki variasi parameter seperti β (hFE) yang bisa

bervariasi antar unit meskipun merek dan tipe transistor tersebut sama.

Dengan adanya variasi seperti ini, deviasi nilai pada hasil pengukuran sangat

umum terjadi dan dapat dianggap sebagai hal yang wajar dalam eksperimen praktis. Oleh

karena itu, meskipun simulasi memberikan nilai yang sangat ideal dan tepat, pengujian

praktis dengan komponen yang tersedia di pasar dapat menghasilkan perbedaan kecil

dalam penguatan atau frekuensi cutoff. Perbedaan ini tidak hanya dipengaruhi oleh

kualitas dan toleransi komponen, tetapi juga oleh faktor-faktor lain seperti kapasitansi

parasitik atau pengaruh lingkungan yang tidak dapat diprediksi sepenuhnya dalam

perhitungan teoritis.

BAB 5

KESIMPULAN

### 5.1. Kesimpulan

Berdasarkan penelitian yang telah dilakukan meliputi perhitungan teoritis,

simulasi, dan pengujian, maka kesimpulan yang dapat ditarik terkait desain two stage BJT

CE Amplifier adalah sebagai berikut,

1. Hasil simulasi memberikan penguatan yang lebih stabil dan ideal dibandingkan

dengan perhitungan teoritis. Namun, pengaruh kapasitansi parasitik dan toleransi

komponen dalam rangkaian fisik menyebabkan penguatan pada frekuensi rendah

(sekitar 20 Hz) sedikit lebih rendah dari yang diharapkan. Pada frekuensi midband

(100 Hz hingga 8 kHz), simulasi dan perhitungan teoritis memberikan hasil yang

hampir identik, menunjukkan bahwa rangkaian bekerja sesuai dengan desain.

Namun, pada frekuensi tinggi (di atas 20 kHz), hasil simulasi menunjukkan

penurunan penguatan yang lebih tajam yang mana telah sesuai dengan target

desain yang diinginkan.

2. Pada hasil pengujian, penguatan yang tercatat pada frekuensi rendah (20 Hz) lebih

rendah dari yang diharapkan, yang disebabkan oleh kapasitansi parasitik dan

toleransi komponen. Pada frekuensi midband (100 Hz dan 1 kHz), penguatan yang

diperoleh pada pengujian lebih tinggi daripada yang dihasilkan oleh simulasi,

menunjukkan bahwa komponen nyata dalam rangkaian memberikan kinerja yang

lebih baik dalam rentang ini.

DAFTAR REFERENSI

[1] R. L. Boylestad, Electronic Devices and Circuit Theory, 11th ed. Pearson Education,

2013.

[2] A. W. Wardhana, Y. Ramadhani, and P. Priswanto, "Design and Simulation of a

Multistages Common-Emitter, Common-Collector, AC Voltage Amplifier,"

Electrical Department, Faculty of Engineering, Universitas Jenderal Soedirman,

Jalan Mayjend Sungkono KM. 5, Purbalingga, 53371, Indonesia, Mar. 16, 2022,

revised July 4, 2022, available online: July 31, 2022.
