izzudin01/Design-of-Two-Stage-BJT-Common-Emitter-Amplifier-2N2222-/(list of files, drawings)

Other design files:
Two Stage CE BJT Amplifier_Izzudin Al Ayyubi.ms14
